qiandawg/riscv-fpu-interrupt/fpu/src/sources_1/imports/RISC-Vrv32m/Basic_and.v

`timescale 1ns / 1ps
//////////////////////////////////////////////////////////////////////////////////
// Company: 
// Engineer: 
// 
// Create Date: 02/18/2024 03:43:45 PM
// Design Name: 
// Module Name: Basic_or
// Project Name: 
// Target Devices: 
// Tool Versions: 
// Description: 
// 
// Dependencies: 
// 
// Revision:
// Revision 0.01 - File Created
// Additional Comments:
// 
//////////////////////////////////////////////////////////////////////////////////


module Basic_and(
    input in1,
    input in2,
    output out
    );
    assign out = in1 & in2;
endmodule
