qiandawg/riscv-fpu-interrupt/fpu/src/sources_1/imports/RISC-Vrv32m/dffe3.v

`timescale 1ns / 1ps
//////////////////////////////////////////////////////////////////////////////////
// Company: 
// Engineer: 
// 
// Create Date: 02/16/2024 09:44:01 AM
// Design Name: 
// Module Name: diffe3
// Project Name: 
// Target Devices: 
// Tool Versions: 
// Description: 
// 
// Dependencies: 
// 
// Revision:
// Revision 0.01 - File Created
// Additional Comments:
// 
//////////////////////////////////////////////////////////////////////////////////


module dffe3(d,clk,clrn,e,q);                         // a 32-bit register
    input      [2:0] d;                                // input d
    input             e;                                // e: enable
    input             clk, clrn;                        // clock and reset
    output reg [2:0] q;                                // output q
    always @(negedge clrn or posedge clk)
        if (!clrn)  q <= 0;                             // q = 0 if reset
        else if (e) q <= d;                             // save d if enabled
endmodule
