qiandawg/riscv-fpu-interrupt/fpu/src/sources_1/imports/RISCVpipelinecode/cla32.v

/************************************************
  The Verilog HDL code example is from the book
  Computer Principles and Design in Verilog HDL
  by Yamin Li, published by A JOHN WILEY & SONS
************************************************/
module cla32 (a,b,ci,s);    // 32-bit carry lookahead adder, no g, p outputs
    input  [31:0] a, b;                                 // inputs: a, b
    input         ci;                                   // input:  carry_in
    output [31:0] s;                                    // output: sum
    wire          g_out, p_out;                         // internal wires
    cla_32 cla (a, b, ci, g_out, p_out, s);             // use cla_32 module
endmodule
