qiandawg/riscv-fpu-interrupt/fpu/src/sources_1/imports/RISCVpipelinecode/pipelinedcpu_decode.v

`timescale 1ns / 1ps
//////////////////////////////////////////////////////////////////////////////////
// Company: 
// Engineer: 
// 
// Create Date: 11/19/2017 06:43:14 PM
// Design Name: 
// Module Name: mccomp_decoder
// Project Name: 
// Target Devices: 
// Tool Versions: 
// Description: 
// 
// Dependencies: 
// 
// Revision:
// Revision 0.01 - File Created
// Additional Comments:
// 
//////////////////////////////////////////////////////////////////////////////////


`include "mfp_ahb_const.vh"

module pipelinedcpu_decode(

    input  [31:0] HADDR,
    output wire[ 2:0] HSEL
);

  // Decode based on most significant bits of the address
  assign HSEL[0] = (HADDR[28:22] == `H_RAM_RESET_ADDR_Match); // 128 KB RAM  at 0xbfc00000 (physical: 0x1fc00000)
  assign HSEL[1] = (HADDR[28]    == `H_RAM_ADDR_Match);       // 256 KB RAM at 0x80000000 (physical: 0x00000000)
  assign HSEL[2] = (HADDR[28:22] == `H_LED_ADDR_Match);       // GPIO at 0xbf800000 (physical: 0x1f800000)
endmodule
