qiandawg/riscv-fpu-interrupt/fpu/src/sources_1/imports/mips-cpu/RTL/Common/io/pmod_als_spi_receiver.v

module pmod_als_spi_receiver
(
    input             clock,
    input             reset_n,
    output            cs,
    output            sck,
    input             sdo,
    output reg [15:0] value
);

    reg [21:0] cnt;
    reg [15:0] shift;

    always @ (posedge clock or negedge reset_n)
    begin       
        if (! reset_n)
            cnt <= 22'b100;
        else
            cnt <= cnt + 22'b1;
    end

    assign sck = ~ cnt [3];
    assign cs  =   cnt [8];

    wire sample_bit = ( cs == 1'b0 && cnt [3:0] == 4'b1111 );
    wire value_done = ( cnt [21:0] == 22'b0 );

    always @ (posedge clock or negedge reset_n)
    begin       
        if (! reset_n)
        begin       
            shift <= 16'h0000;
            value <= 16'h0000;
        end
        else if (sample_bit)
        begin       
            shift <= (shift << 1) | {15'b0, sdo};
        end
        else if (value_done)
        begin       
            value <= shift;
        end
    end

endmodule
